CoEmergenceLab/WormConnect/README.md

# WormConnect
Code, circuits, diagrams, etc for WormConnect project
