CoEmergenceLab/WormConnect/circuits/dotstar_darkfield_illumnator_schem.png

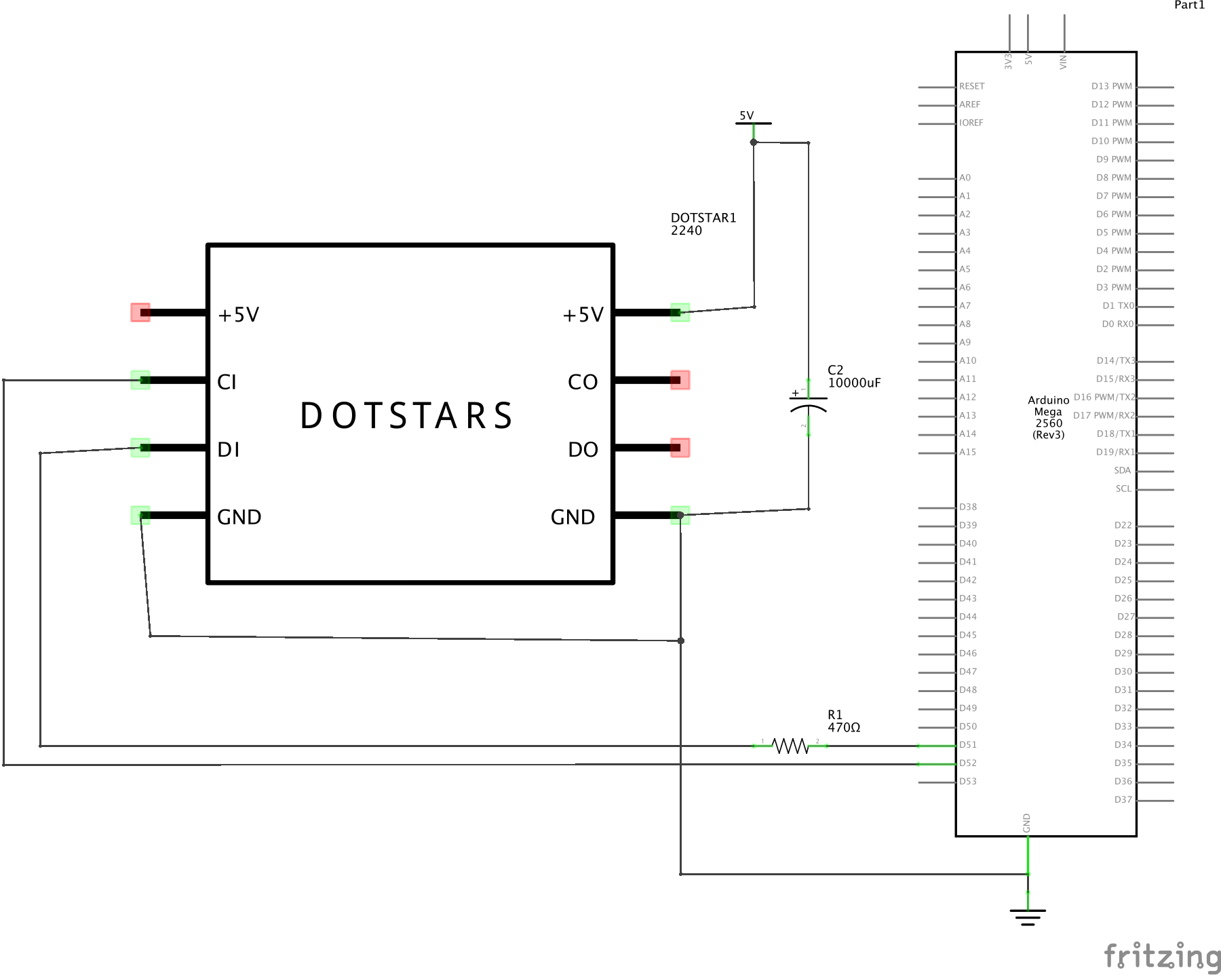
circuits/dotstar_darkfield_illumnator_schem.png
