CoEmergenceLab/WormConnect/circuits/HR_Contact_schem.png

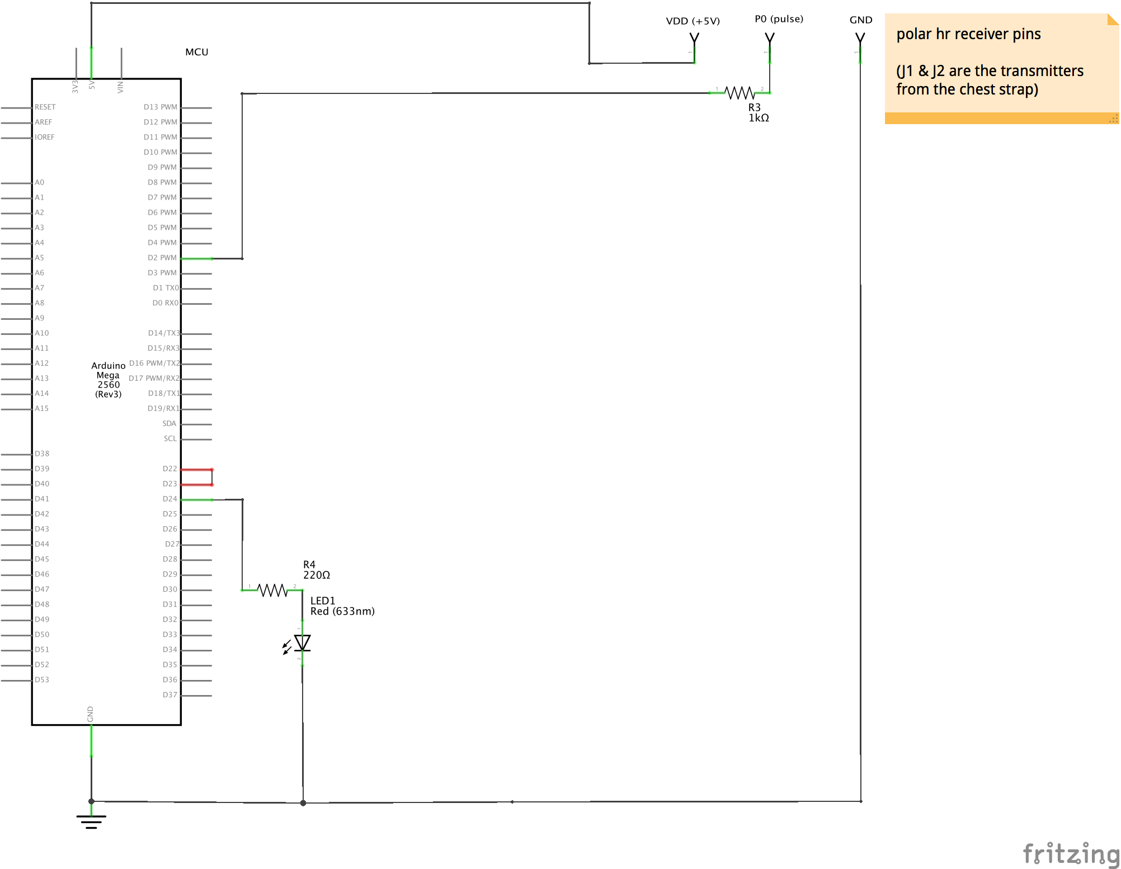
circuits/HR_Contact_schem.png
