CoEmergenceLab/WormConnect/circuits/LightRelays_schem.png

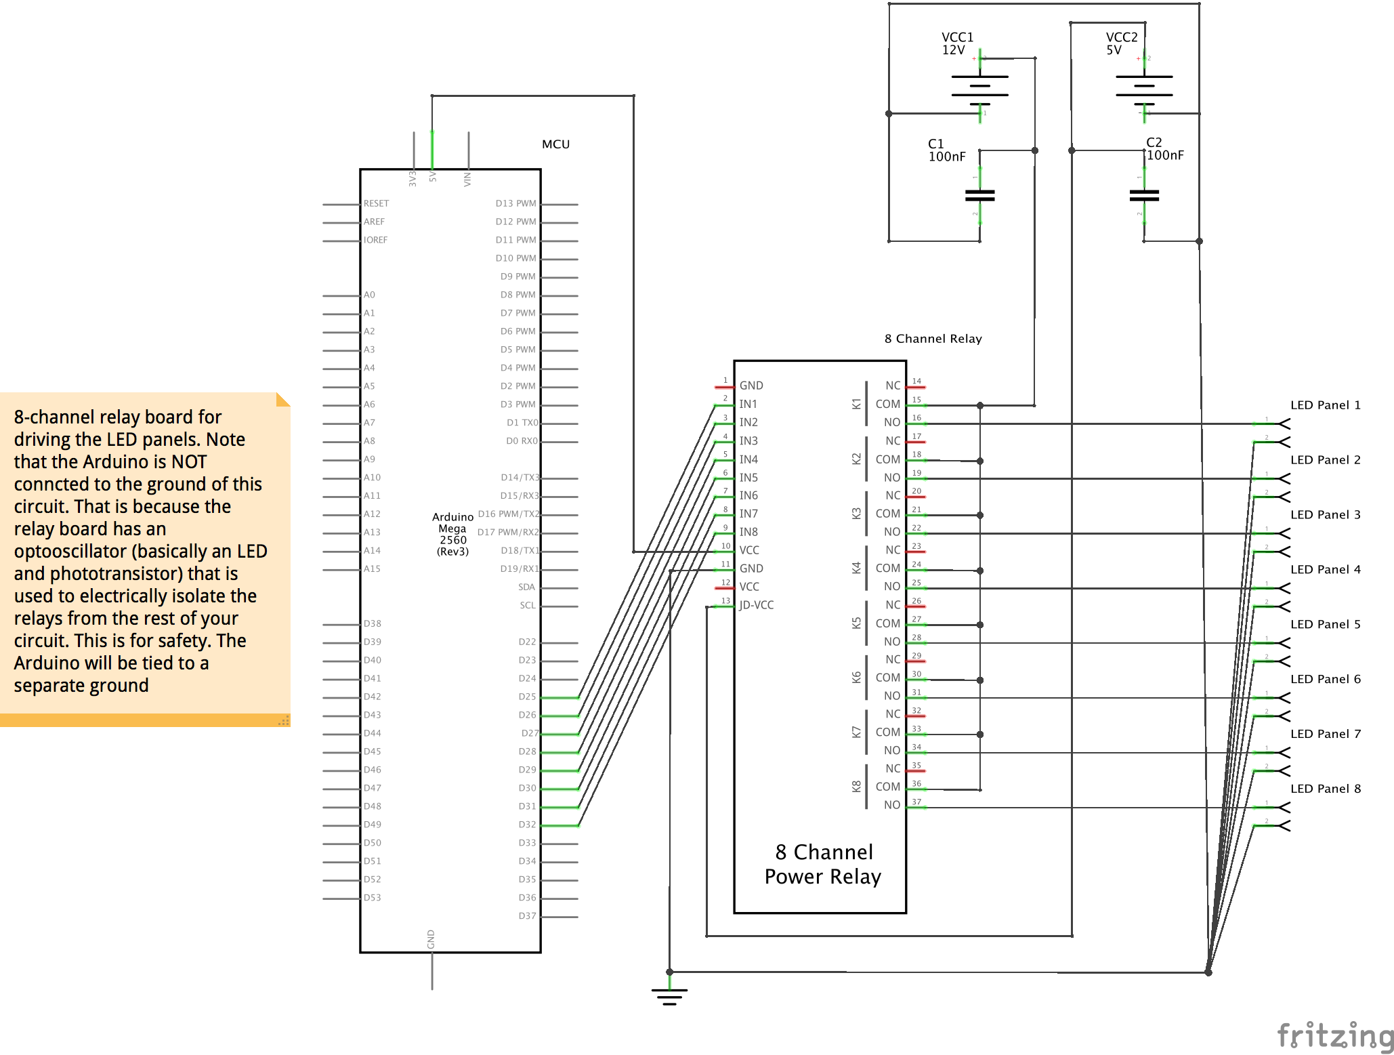
circuits/LightRelays_schem.png
