CoEmergenceLab/WormConnect/circuits/Peltier_schem.png

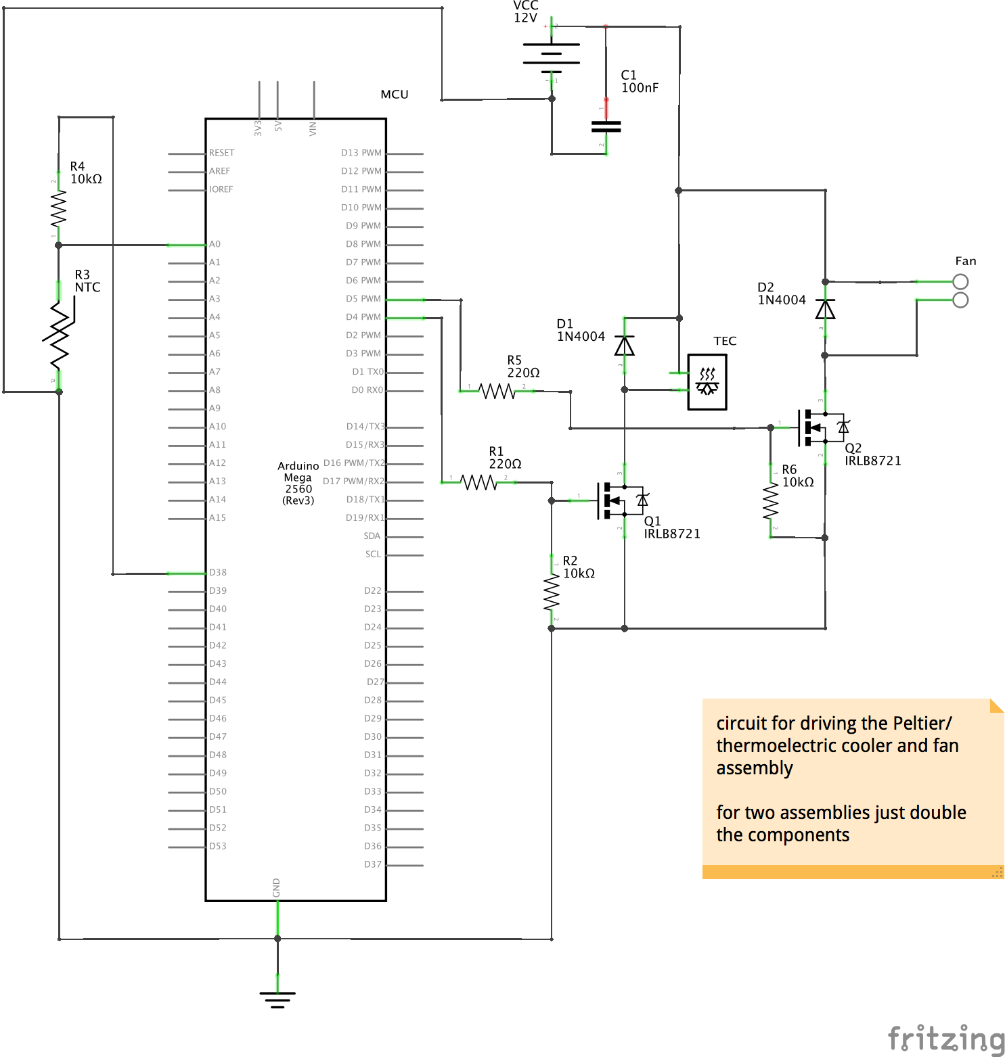
circuits/Peltier_schem.png
