CoEmergenceLab/WormConnect/circuits/polarhrreceiver.png

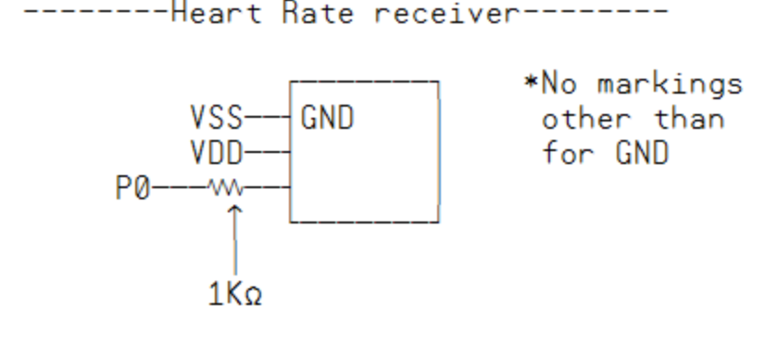
circuits/polarhrreceiver.png
