CoEmergenceLab/WormConnect/circuits/syringePumpStepperMotor.png

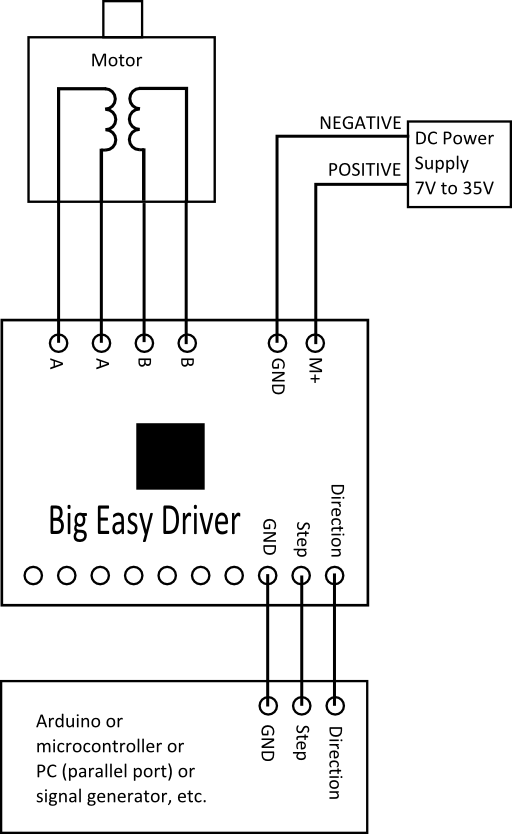
circuits/syringePumpStepperMotor.png
