CoEmergenceLab/WormConnect/diagrams/Human-C.elegans System Diagram.png

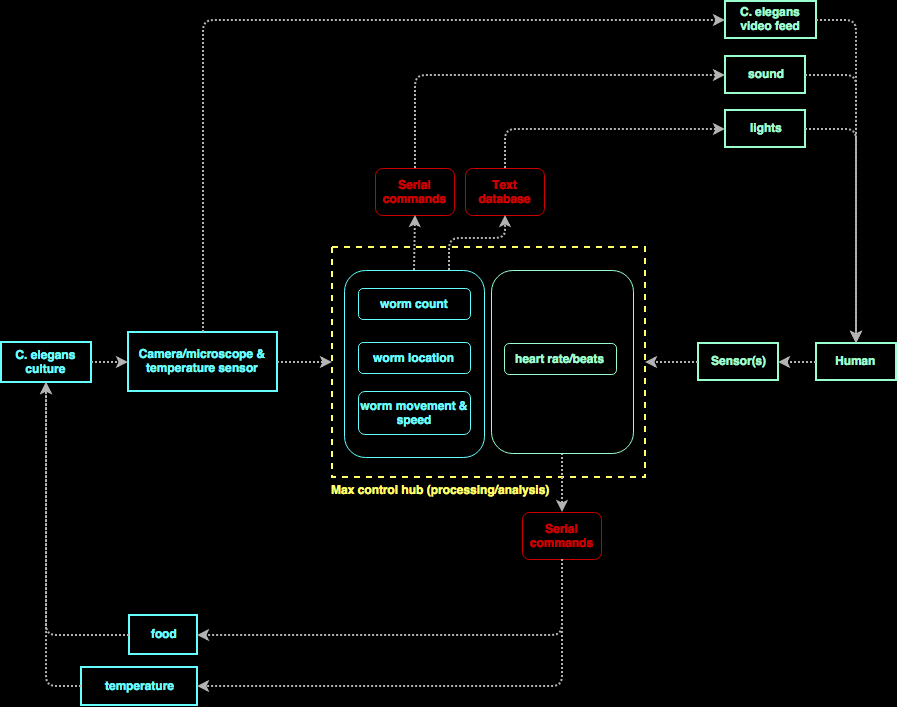
diagrams/Human-C.elegans System Diagram.png
