CoEmergenceLab/WormConnect/(list of files, drawings)

Other design files:
circuits/dotstar_darkfield_illumnator.fzz
circuits/HR_Contact.fzz
circuits/LightRelays.fzz
circuits/Peltier.fzz
