CoEmergenceLab/WormConnect/(commit log)

2017-12-16 first commit!
    Adding code, circuits, etc
2017-12-16 added Arduino test sketches
    test sketches for PID/Peltiers, dotstar leds and relays/lights
2018-01-18 Changes to hex codes for LED color
    Changed hex codes for Dotstar LED colors to shades of red (works better
    for dark-field illumination)
2018-01-21 Added Max code for Meditate stage
2018-01-25 Change syringe pump volume & barrel length
2018-01-25 change syringe pump bolus sizes
2018-01-31 Worm tracking test
    created a Worm tracking test patch and edited Arduino dotstar test
    sketch (trying come different colors)
2018-02-01 Testing the binary communication light relay module
2018-02-02 Minor changes to Max project file and PID code
2018-02-02 Added PID calculator Excel doc
    [pid-2.xlsx]
2018-02-12 worm direction and stages-related logic
    Changes to logic for determining worm direction, stages and
    corresponding syringe pump & peltier logic
2018-02-14 worm tracking & dotstar led testing
2018-02-16 dotstar led, tracking and peltier testing
2018-02-25 added worm tracking calibration instructions & clarified peltier comments
2018-02-26 Change peltier object parameters & num dostar leds
2018-03-03 change number of dotstar uses & syringe pump msg
2018-03-07 syringe pump bolus size & worm vid settings
2018-03-08 Now stages 0, 1 & 2 trigger binary lights
2018-03-08 syringe pump bolus size
2018-03-08 changed fan speed
2019-03-07 added Fritzing files
    [HR_Contact.fzz, LightRelays.fzz, Peltier.fzz, dotstar_darkfield_illumnator.fzz]
